k-vanier/sysmonF401/tools/beastie_trident.gif

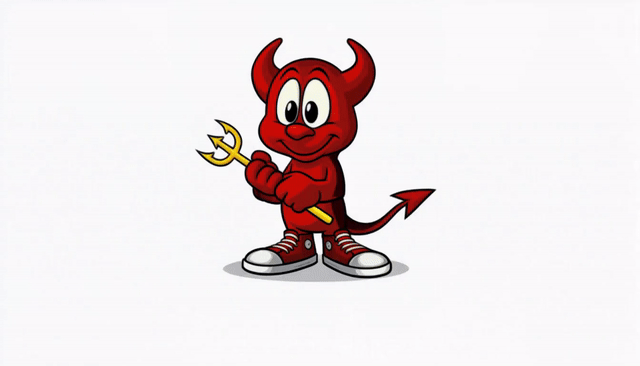
tools/beastie_trident.gif
