k-vanier/sysmonF401/firmware/sysmonf401/sysmonf401.ioc

Mcu.UserName=STM32F401CCUx
PA1.GPIO_Label=TFT_BLK
PA1.Signal=GPIO_Output
PA11.Signal=USB_OTG_FS_DM
PA12.Signal=USB_OTG_FS_DP
PA13.Signal=SYS_JTMS-SWDIO
PA14.Signal=SYS_JTCK-SWCLK
PA2.GPIO_Label=TFT_RST
PA2.Signal=GPIO_Output
PA3.GPIO_Label=TFT_DC
PA3.Signal=GPIO_Output
PA4.GPIO_Label=TFT_CS
PA4.Signal=GPIO_Output
PA5.Signal=SPI1_SCK
PA7.Signal=SPI1_MOSI
PC13-ANTI_TAMP.GPIO_Label=LED
PC13-ANTI_TAMP.Signal=GPIO_Output
