k-vanier/sysmonF401/firmware/sysmonf401/Core/Inc/st7789.h

/* Pilote minimal ST7789 1.9" (170x320) sur SPI1, en paysage 320x170. */
#ifndef ST7789_DRV_H
#define ST7789_DRV_H

#include <stdint.h>

#define ST7789_W 320
#define ST7789_H 170

/* Couleur RGB565 à partir de composantes 8 bits. */
#define RGB565(r, g, b) ((uint16_t)((((r) & 0xF8) << 8) | (((g) & 0xFC) << 3) | ((b) >> 3)))

void st7789_init(int flip); /* flip = 1 : paysage retourné */
void st7789_backlight(int on);
void st7789_fill_rect(int x, int y, int w, int h, uint16_t color);
/* Envoie w*h pixels (couleurs RGB565 natives) dans le rectangle. */
void st7789_blit(int x, int y, int w, int h, const uint16_t *px);
/* Envoi par morceaux : begin ouvre le rectangle, push ajoute des pixels
 * (w*h au total, ligne par ligne), end termine. */
void st7789_begin(int x, int y, int w, int h);
void st7789_push(const uint16_t *px, uint32_t n);
void st7789_end(void);

#endif
