k-vanier/sysmonF401/(commit log)

2026-10-31 sysmonF401 : afficheur CPU / RAM / température / réseau pour FreeBSD
    Firmware Black Pill STM32F401 + écran ST7789 1.9" (PlatformIO, USB CDC)
    et programme d'envoi FreeBSD en Go avec son service rc.d.
2026-10-31 sysmonF401 : script rc.d toujours en fins de ligne LF
2026-10-31 sysmonF401 : firmware.bin compilé, à flasher avec dfu-util sous FreeBSD
    PlatformIO n'a pas de toolchain ARM pour FreeBSD : le binaire est livré
    dans le dépôt pour flasher directement depuis le serveur.
2026-10-31 sysmonF401 : firmware en projet STM32CubeIDE, flashé par ST-Link
    Le firmware PlatformIO / Arduino est remplacé par un projet STM32CubeIDE
    généré par CubeMX (HAL, USB CDC 0483:5740, SPI1 à 42 Mbit/s, 84 MHz),
    avec un pilote ST7789 en C et le même protocole texte : le programme
    FreeBSD ne change pas. Le flash passe par la ST-Link en SWD, ce qui évite
    le bootloader DFU de la F401 qui ne s'énumérait pas.
2026-10-31 sysmonF401 : SPI à 10,5 Mbit/s et mire RVB au démarrage
    42 Mbit/s est trop rapide pour un écran câblé en fils Dupont. La mire
    rouge / vert / bleu au démarrage permet de vérifier l'écran sans l'USB.
2026-10-31 sysmonF401 : flash par OpenOCD pour les clones ST-Link dans le README
    STM32CubeProgrammer refuse les clones ST-Link V2 (DEV_CONNECT_ERR) ;
    l'OpenOCD fourni avec CubeIDE les accepte via stlink-dap. Le README
    précise aussi d'importer firmware/sysmonf401 et non la racine du dépôt.
2026-10-31 sysmonF401 : affichage pleine résolution et animation GIF
    Polices lissées (Go fonts, 16 niveaux) à leur taille réelle au lieu de la
    police 5x7 agrandie, barres et carte aux bords lissés, et un GIF animé
    (Beastie) sur une carte blanche à gauche avec le nom du serveur.
    tools/mkassets.py génère polices et images (palette commune, RLE) dans
    assets.c ; tools/preview compile l'affichage sur PC pour en tirer des
    captures. Firmware : 186 Ko de flash sur 256.
2026-10-31 sysmonF401 : scripts shell toujours en fins de ligne LF
2026-10-31 sysmonF401 : fond blanc, système et version sous l'animation
    Tout l'écran passe sur fond blanc (celui du GIF), sans carte. Sous Beastie,
    le système et sa version comme uname -sr (« FreeBSD 15.0-RELEASE-p9 »)
    au lieu du nom de la machine : sysmonf401 envoie la clé os= (option -label),
    le firmware écrit « FreeBSD » aux couleurs du logo et la version dessous.
2026-10-31 sysmonF401 : animation envoyée colonne par colonne, SPI à 21 Mbit/s
    L'animation scintillait : chaque image partait ligne par ligne en 23 ms,
    en travers du balayage de la dalle (horizontal en paysage), qui affichait
    un mélange en diagonale des deux images. Les images sont maintenant
    stockées et envoyées colonne par colonne, dans l'axe du balayage, et le
    SPI passe à 21 Mbit/s (une image en ~12 ms). Bonus : 96 Ko au lieu de 110.
2026-10-31 sysmonF401 : nouvelle animation (Beastie au trident), codage différentiel
    Le GIF de 8 s (120 images) ne tenait pas dans la flash image par image.
    mkassets.py stocke maintenant la première image entière puis seulement
    les différences d'une image à l'autre, avec une tolérance qui écarte le
    bruit de compression ; le fond presque blanc est ramené au blanc pur.
    Le firmware garde l'image affichée en RAM et n'envoie que les morceaux de
    colonne modifiés. Options --crop, --step, --noise, --max-w/-h, --colors.
    60 images de 126x120 : 142 Ko, firmware 218 Ko sur 256. La prévisualisation
    vérifie que l'animation revient exactement à sa première image.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
    [assets.h, gfx.c, gfx.h, preview.c, sysmon.c]
2026-10-31 sysmonF401 : version seule sous l'animation, GIF éclairci
    Sous Beastie, seulement la version du système comme uname -r
    (« 15.0-RELEASE-p9 ») sur une ligne avec la pastille ; l'animation profite
    de la place libérée (134x128). mkassets.py : option --gamma (0.7 ici) pour
    éclaircir le GIF trop sombre, et un pixel qui redevient fond est toujours
    réécrit (des restes d'étincelles proches du blanc restaient affichés).
2026-10-31 sysmonF401 : sans pastille sous l'animation, GIF plus clair
    La pastille d'état sous l'animation est retirée (la LED de la carte
    indique toujours la réception) : la version est centrée, seule. Le GIF
    passe en gamma 0.5, il restait trop sombre sur l'écran.
2026-10-31 sysmonF401 : README, plus de pastille d'état
2026-10-31 sysmonF401 : graphe réseau en miroir sur toute la largeur
    Débits sur une ligne (réception à gauche, envoi à droite), nombre en
    couleur et unité en petit ; graphe en miroir sur toute la largeur de la
    colonne (~3 min) : réception au-dessus de l'axe, envoi en dessous, chacun
    avec son échelle. Pour la place, la grande police perd ses lignes vides
    au-dessus des chiffres (mkassets.py) et les jauges passent à 32 px.
2026-10-31 sysmonF401 : page torrents (c411_transmission), alternance toutes les 10 s
    sysmonf401 lit /var/log/torrents_status (résumé de c411_transmission) et
    l'envoie toutes les 5 s en clés t... (torrents.go, toutes les variantes de
    build_status_line : pourcentages, manque, Nerr, top/flop sans nom, ERREUR).
    La colonne de droite alterne alors toutes les 10 s entre la page système et
    une page torrents du même style : DL et places (avancement, attente,
    erreurs), ratio avec totaux envoyé / reçu, espace libre, top / flop, action
    du dernier passage et place dispo / manquante. Page retirée sans résumé
    depuis 30 s. L'historique réseau continue pendant la page torrents.
    Polices : triangles ▲ ▼ e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
2026-10-31 sysmonF401 : page torrents en cartes
    Cartes arrondies gris clair : DL (2/3, pastille par place), RATIO (vert
    à partir de 1, barre envoyé / reçu), disque (dispo à gauche, libre à
    droite, barre verte pour le dispo et rose pâle pour la place déjà
    promise). Puis top / flop, erreurs et action du dernier passage avec les
    totaux envoyé / reçu. L'erreur de c411 devient une carte rouge pâle.
2026-10-31 sysmonF401 : photos de l'écran et du câblage
    docs/photo-screen.jpg (l'écran en marche) en tête du README,
    docs/photo-wiring.jpg (le câblage sur la Black Pill) dans la partie Wiring.
